nicobigio01/microwave-amplifier/README.md

These are the main sources used in my bachelor thesis.

The sources are a little bit messy (latex ones in particular) but I was tight on time.
