nicobigio01/microwave-amplifier/pcb/tesina.kicad_pcb

## KiCad design pcb/tesina.kicad_pcb (2023-06-19)

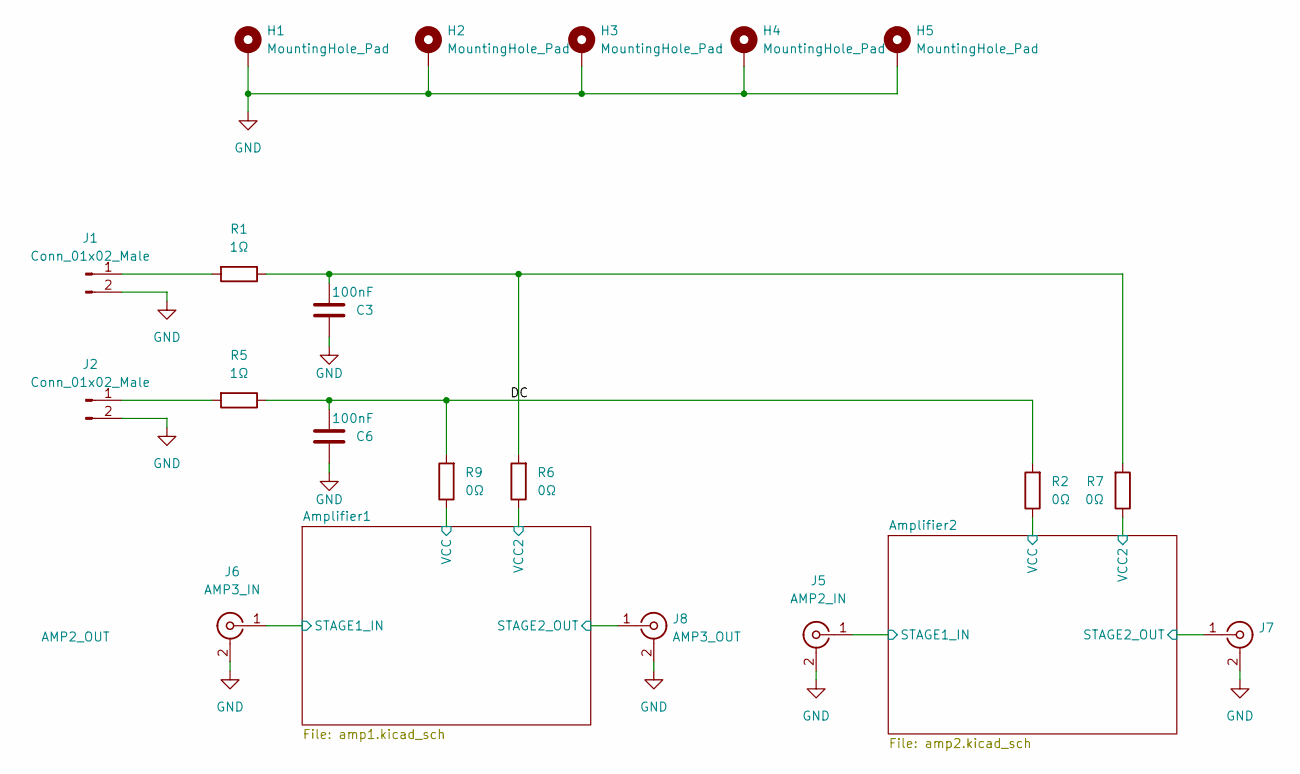
[picture p1: schematic tesina.kicad_sch]

Parts:
C3, C6: 100nF; C_1206_3216Metric
H1: MountingHole_Pad; MountingHole_2.5mm_Pad_TopBottom
H2, H3, H4, H5: MountingHole_Pad; MountingHole_2.7mm_M2.5_DIN965_Pad_TopBottom
J1, J2: Conn_01x02_Male; Connector_Pad
J5: AMP2_IN; Linx_CONSMA003.031-L-G
J6: AMP3_IN; Linx_CONSMA003.031-L-G
J7: AMP2_OUT; Linx_CONSMA003.031-L-G
J8: AMP3_OUT; Linx_CONSMA003.031-L-G
R1, R5: 1Ω; R_0603_1608Metric
R2, R6, R7, R9: 0Ω; R_0603_1608Metric

Connections:
/Amplifier1/STAGE1_IN: J6.1 (In); also elsewhere on the board
/Amplifier1/STAGE2_OUT: J8.1 (In); also elsewhere on the board
/Amplifier1/VCC: R9.1; also elsewhere on the board
/Amplifier1/VCC2: R6.1; also elsewhere on the board
/Amplifier2/STAGE1_IN: J5.1 (In); also elsewhere on the board
/Amplifier2/STAGE2_OUT: J7.1 (In); also elsewhere on the board
/Amplifier2/VCC: R2.1; also elsewhere on the board
/Amplifier2/VCC2: R7.1; also elsewhere on the board
/DC: C6.2, R2.2, R5.1, R9.2
GND: C3.1, C6.1, H1.1, H2.1, H3.1, H4.1, H5.1, J1.2, J2.2, J5.2 (Ext), J6.2 (Ext), J7.2 (Ext), J8.2 (Ext); also elsewhere on the board
unnamed: C3.2, R1.1, R6.2, R7.2
unnamed: J1.1, R1.2
unnamed: J2.1, R5.2

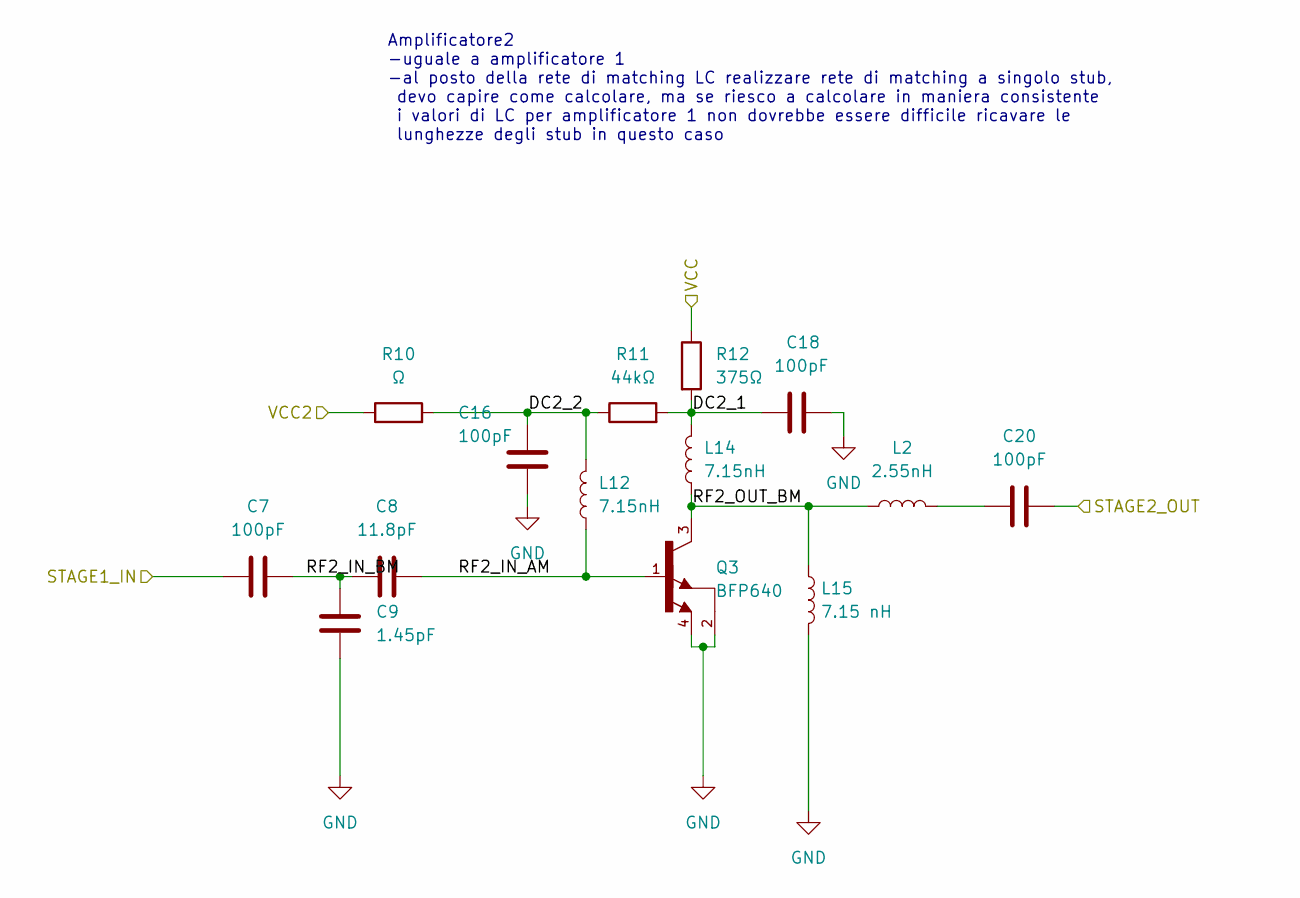
[picture p2: schematic amp2.kicad_sch]

Parts:
C7, C16, C18, C20: 100pF; C_0603_1608Metric
C8: 11.8pF; C_0603_1608Metric
C9: 1.45pF; C_0603_1608Metric
L2: 2.55nH; Coilcraft_0906-xxLx
L12, L14: 7.15nH; Coilcraft_1606-xxLx
L15: 7.15 nH; Coilcraft_mod
Q3: BFP640; SOT-343
R10: Ω; R_0603_1608Metric
R11: 44kΩ; R_0603_1608Metric
R12: 375Ω; R_0603_1608Metric

Connections:
/Amplifier2/DC2_1: C18.1, L14.2, R11.2, R12.2
/Amplifier2/DC2_2: C16.1, L12.2, R10.2, R11.1
/Amplifier2/RF2_IN_AM: C8.2, L12.1, Q3.1
/Amplifier2/RF2_IN_BM: C7.2, C8.1, C9.1
/Amplifier2/RF2_OUT_BM: L2.1, L14.1, L15.1, Q3.3
/Amplifier2/STAGE1_IN: C7.1; also elsewhere on the board
/Amplifier2/STAGE2_OUT: C20.2; also elsewhere on the board
/Amplifier2/VCC: R12.1; also elsewhere on the board
/Amplifier2/VCC2: R10.1; also elsewhere on the board
GND: C9.2, C16.2, C18.2, L15.2, Q3.2, Q3.4; also elsewhere on the board
unnamed: C20.1, L2.2

Notes on the sheet:
Amplificatore2 -uguale a amplificatore 1 -al posto della rete di matching LC realizzare rete di matching a singolo stub, devo capire come calcolare, ma se riesco a calcolare in maniera consistente i valori di LC per amplificatore 1 non dovrebbe essere difficile ricavare le lunghezze degli stub in q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

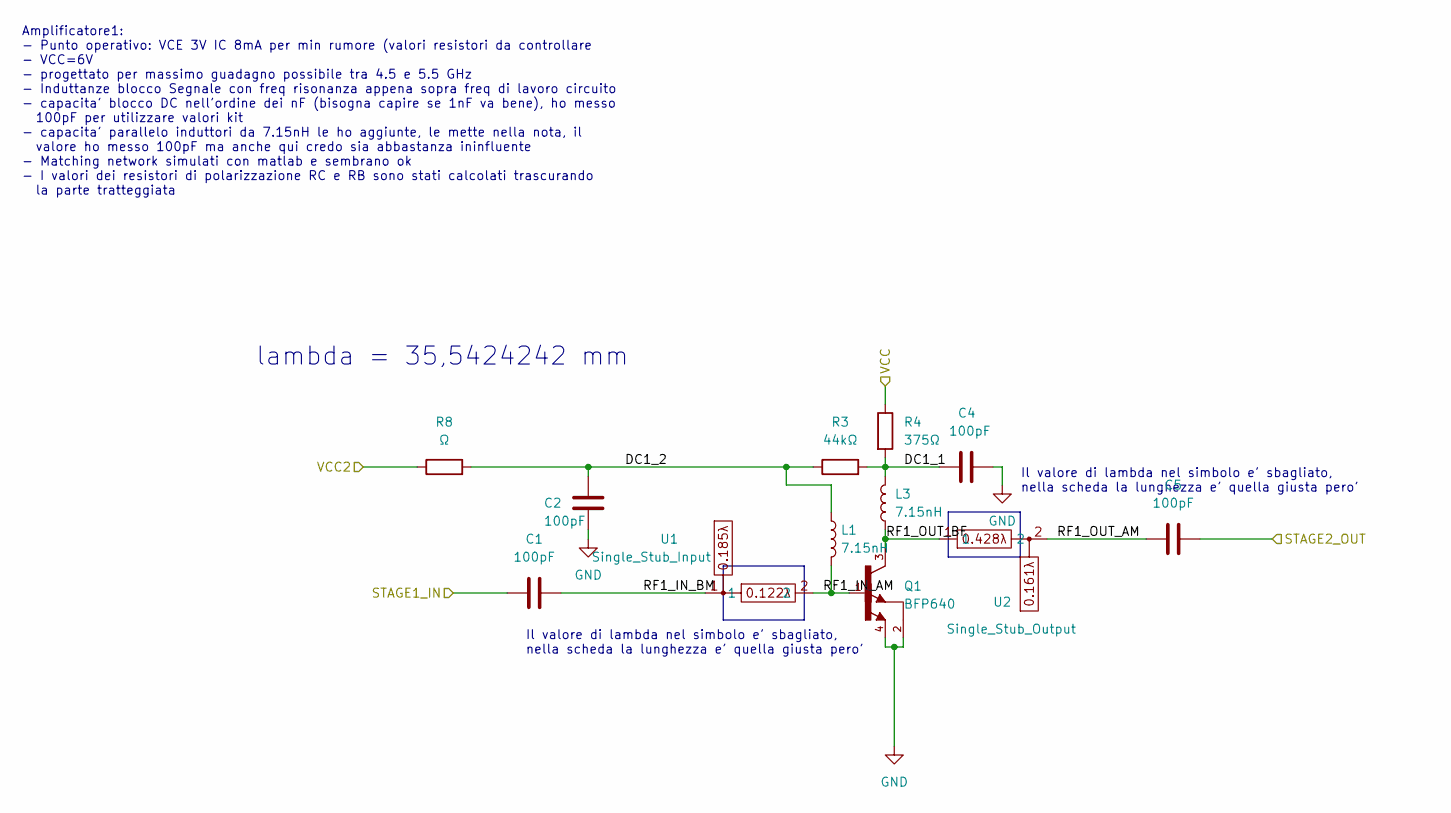
[picture p3: schematic amp1.kicad_sch]

Parts:
C1, C2, C4, C5: 100pF; C_0603_1608Metric
L1, L3: 7.15nH; Coilcraft_1606-xxLx
Q1: BFP640; SOT-343
R3: 44kΩ; R_0603_1608Metric
R4: 375Ω; R_0603_1608Metric
R8: Ω; R_0603_1608Metric
U1: Single_Stub_Input; Microwave_Stub_In2
U2: Single_Stub_Output; Microwave_Stub_Out2

Connections:
/Amplifier1/DC1_1: C4.1, L3.2, R3.2, R4.2
/Amplifier1/DC1_2: C2.1, L1.1, R3.1, R8.2
/Amplifier1/RF1_IN_AM: L1.2, Q1.1, U1.2
/Amplifier1/RF1_IN_BM: C1.2, U1.1
/Amplifier1/RF1_OUT_AM: C5.1, U2.2
/Amplifier1/RF1_OUT_BF: L3.1, Q1.3, U2.1
/Amplifier1/STAGE1_IN: C1.1; also elsewhere on the board
/Amplifier1/STAGE2_OUT: C5.2; also elsewhere on the board
/Amplifier1/VCC: R4.1; also elsewhere on the board
/Amplifier1/VCC2: R8.1; also elsewhere on the board
GND: C2.2, C4.2, Q1.2, Q1.4; also elsewhere on the board

Notes on the sheet:
Amplificatore1: - Punto operativo: VCE 3V IC 8mA per min rumore (valori resistori da controllare - VCC=6V - progettato per massimo guadagno possibile tra 4.5 e 5.5 GHz - Induttanze blocco Segnale con freq risonanza appena sopra freq di lavoro circuito - capacita' blocco DC nell'ordine dei nF (bisog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
lambda = 35,5424242 mm
Il valore di lambda nel simbolo e' sbagliato, nella scheda la lunghezza e' quella giusta pero'

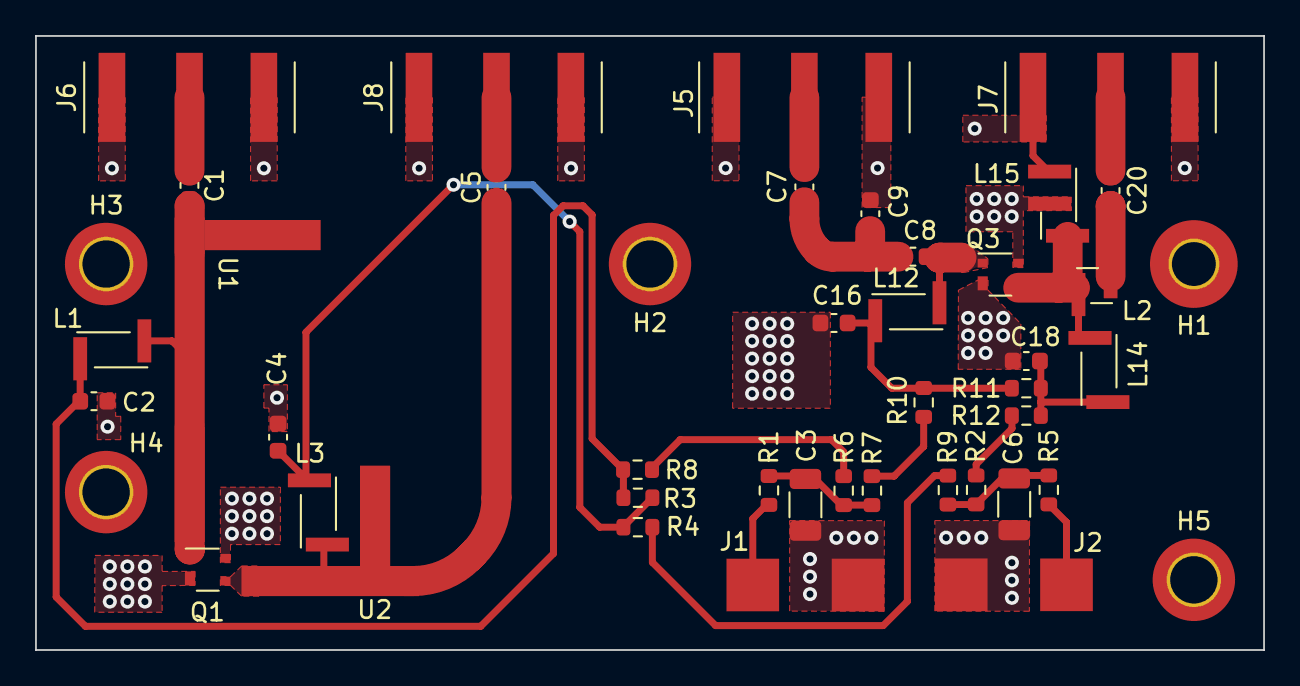
[picture p4: board tesina.kicad_pcb from above]

Board: 2 copper layers, 70.0 x 35.0 mm, 45 parts (0 on the bottom side), 25 nets.
