nicobigio01/microwave-amplifier/(commit log)

2023-04-01 started working on schematic
    [amp1.kicad_sch, amp2.kicad_sch, amp3.kicad_sch, tesina.kicad_pcb, tesina.kicad_sch]
2023-04-01 Added values for matching network
    [amp1.kicad_sch, amp2.kicad_sch, tesina.kicad_sch]
2023-04-13 Created LTSpice simulation and added suggested fix
    [amp1.kicad_sch, amp2.kicad_sch, tesina.kicad_sch]
2023-04-27 Started working on board
    [tesina.kicad_pcb]
2023-04-27 Schematic modified as discussed
    [amp1.kicad_sch, amp2.kicad_sch, tesina.kicad_sch]
2023-05-11 Deleted double stage, updated stub stage, L stage and PCB
    [amp1.kicad_sch, amp2.kicad_sch, tesina.kicad_pcb, tesina.kicad_sch]
2023-05-13 Started PCB Layout
    [amp1.kicad_sch, amp2.kicad_sch, tesina.kicad_pcb, tesina.kicad_sch]
2023-05-15 backup version before changes
    [amp1.kicad_sch, tesina.kicad_pcb, tesina.kicad_sch]
2023-05-15 PCB modified according to suggestions
    [amp1.kicad_sch, amp2.kicad_sch, tesina.kicad_pcb, tesina.kicad_sch]
2023-05-16 design finished
    [amp1.kicad_sch, tesina.kicad_pcb, tesina.kicad_sch]
2023-05-18 PCB ready for review
    [amp1.kicad_sch, tesina.kicad_pcb, tesina.kicad_sch]
2023-06-28 first s-par data
    [L_NO_COP.csv, STUB_NO_COP.csv]
2023-06-29 matlab/BFP640
    L matching VCE 2V IC 40mA
2023-07-01 preliminary part of -punto di lavoro- done
2023-07-06 All data collected working on thesis
    [L_NO_COP.csv, STUB_NO_COP.csv]
